BMellor/intelliDesk/README.md

intelliDesk
===========

Intelligent LED lighting controller for a lab workspace. Class project for ECE 5780 University of Utah Spring 2014.
