BMellor/intelliDesk/Design Docs/OLED's/0.96in Blue&White Models/ER-OLED0.96-2_4-Wire-SPI_DemoCode.txt

//----------------------------------------------------------------------
//EASTRISING TECHNOLOGY CO,.LTD.//
// Module    : ER-OLED0.96-2  0.96" (BLUE)
// Lanuage   : C51 Code
// Create    : JAVEN
// Date      : May-16-2013
// Drive IC  : SSD1306
// INTERFACE : 4 Line SPI
// MCU 		 : AT89LV52
// VDD		 : 3.3V   VBAT: 3.6V    
//----------------------------------------------------------------------

#include <AT89X52.H>
#include <intrins.h>

#define uint unsigned int
#define uchar unsigned char
#define RS                     P3_3
#define CS1                    P3_5
#define RST                    P3_4
#define SCLK                  P1_0
#define SDA                   P1_1
sbit	int0=P3^2;
sbit key_add=P0^1;
sbit key_dec=P0^2;
uchar Contrast_level=0xf0;
bit log=0;

#define Start_column	0x00
#define Start_page		0x00
#define	StartLine_set	0x00

void Delay1(uint n);
void Write_number(uchar code *n,uchar k,uchar station_dot);
void display_Contrast_level(uchar number);
void adj_Contrast(void);
void Delay(uint n);
void Write_Data(unsigned char dat);
void Write_Instruction(unsigned char cmd);
void Set_Page_Address(unsigned char add);
void Set_Column_Address(unsigned char add);
void Set_Contrast_Control_Register(unsigned char mod);
void Initial(void);
void Display_Chess(unsigned char value);
void Display_Chinese(unsigned char ft[]);
void Display_Chinese_Column(unsigned char ft[]);
void Display_Picture(unsigned char pic[]);

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
0x00,0x00,0x01,0x01,0x01,0x81,0x41,0xA1,0x51,0xAB,0x57,0xAB,0x55,0xAA,0x75,0xBE,
0x5B,0x2D,0x86,0xF3,0xFF,0xFF,0xFF,0xFF,0xFF,0xFF,0xFF,0xFF,0xFF,0xFF,0xBB,0xCD,
0x56,0x49,0x75,0x9F,0x63,0x09,0xC7,0xF0,0xFF,0xFF,0xFF,0xFF,0xFF,0xFF,0xFF,0xFF,
0xFF,0xFF,0xFF,0xFF,0xFF,0x00,0x00,0x00,0x00,0x10,0x11,0x30,0x30,0x1F,0x08,0x08,
0x08,0x0C,0x06,0x03,0x3F,0x1F,0x02,0x06,0x0C,0x1C,0x08,0x00,0x00,0x00,0x00,0x00,
0x00,0x00,0x00,0x00,0x00,0x00,0x00,0x00,0x00,0x00,0x00,0x7F,0xF0,0x00,0x00,0x00,
0x00,0x00,0x01,0x03,0x06,0x0C,0x0C,0x08,0x10,0x00,0x05,0x03,0x03,0x03,0x00,0x00,
0x00,0x00,0x00,0x00,0x00,0x00,0x00,0x00,0x00,0x00,0x00,0x00,0x00,0x00,0x00,0x00,
0x00,0x00,0x00,0xA0,0x5C,0xAB,0x55,0xAA,0x55,0xAA,0x55,0xAA,0x55,0xEA,0x65,0xB2,
0xF9,0xFE,0xFF,0xFF,0xFF,0xFF,0xFF,0xFF,0xFF,0xFF,0xFF,0xBF,0x5E,0x9F,0x48,0x2A,
0x35,0xBA,0xC5,0xF2,0xFC,0xFF,0xFF,0xFF,0xFF,0xFF,0xFF,0xFF,0xFF,0xFF,0xFF,0xFF,
0xFF,0xFF,0xFF,0xFF,0xFF,0x00,0x00,0x00,0x00,0x20,0x10,0x90,0xD0,0xFC,0xD4,0x90,
0x18,0xC8,0x48,0x48,0xC8,0xC8,0x08,0xF8,0x08,0x18,0x18,0x08,0x00,0x00,0x00,0x00,
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
};

void Step(void) interrupt 0 using 0
{
	Delay1(300);
	if(int0==0)
 // {	while(IE0);
	log=!log;
 // }
   while(!int0);
  return;

}

void Delay1(uint n)
{while(n--);

	return;
}

void Write_number(uchar code *n,uchar k,uchar station_dot)
{uchar i; 
			for(i=0;i<8;i++)
				{
				Write_Data(*(n+16*k+i));
				}
				
	Set_Page_Address(Start_page+1)	;
    Set_Column_Address(Start_column+station_dot*8);	
			for(i=8;i<16;i++)
				{
				Write_Data(*(n+16*k+i));
				}
}

void display_Contrast_level(uchar number)
{	uchar number1,number2,number3;
	number1=number/100;number2=number%100/10;number3=number%100%10;
	Set_Column_Address(Start_column+0*8);
	Set_Page_Address(Start_page);
    Write_number(num,number1,0);
	Set_Column_Address(Start_column+1*8);
	Set_Page_Address(Start_page);
	Write_number(num,number2,1);
	Set_Column_Address(Start_column+2*8);
	Set_Page_Address(Start_page);
	Write_number(num,number3,2);

}

void adj_Contrast(void)
{	Delay1(300);
 	 if((key_add==0)||(key_dec==0))
		{		
		 if	(key_add==0) 
			{Contrast_level+=1;
		   	Set_Contrast_Control_Register(Contrast_level);	
			display_Contrast_level(Contrast_level);
			Delay1(18000);
			if(key_add==0)
				{Delay1(18000);
					if(key_add==0)			
						{Delay1(18000);
							if(key_add==0)
								{Delay1(18000);
									if(key_add==0)

										{while(key_add==0)
											{Contrast_level+=1; 
		   										Set_Contrast_Control_Register(Contrast_level);	
												display_Contrast_level(Contrast_level);
							 					Delay1(20000); 
											}
										}
								}				
						}						
				}												
			}

		 if	(key_dec==0) 
			{Contrast_level-=1; 
		   	Set_Contrast_Control_Register(Contrast_level);	
			display_Contrast_level(Contrast_level);
			Delay1(18000);
			if(key_dec==0)
				{Delay1(18000);
					if(key_dec==0)			
						{Delay1(18000);
							if(key_dec==0)
								{Delay1(18000);
									if(key_dec==0)

										{while(key_dec==0)
											{Contrast_level-=1; 
		   										Set_Contrast_Control_Register(Contrast_level);	
												display_Contrast_level(Contrast_level);
							 					Delay1(20000); 
											}
										}
								}				
						}						
				}												
			}

	  	}
}

void Delay(uint n)
{while(n)
 {    if((key_add==0)||(key_dec==0)) adj_Contrast();
	  n--;
 }
 	for(;log==1;)
	{
 	 if((key_add==0)||(key_dec==0)) adj_Contrast();
	}

	return;
}

void Write_Data(unsigned char dat)
{
  unsigned char  m,da;
  unsigned int j;
     RS=1;
     CS1=0;
     da=dat;
  for(j=0;j<8;j++)
    {
      m=da;
      SCLK=0;
      m=m&0x80;
      if(m==0x80)
        {
           SDA=1;
         }
       else
         {
             SDA=0;
         }
        
        da=da<<1;
        SCLK=1;
      }
  CS1=1;
}

void Write_Instruction(unsigned char cmd)
{
  unsigned char  m,da;
  unsigned int j;
     RS=0;
     CS1=0;
     da=cmd;
  for(j=0;j<8;j++)
    {
      m=da;
      SCLK=0;
      m=m&0x80;
      if(m==0x80)
        {
           SDA=1;
         }
       else
         {
             SDA=0;
         }
        
        da=da<<1;
        SCLK=1;
      }
  CS1=1;
}

// Set page address 0~7
void Set_Page_Address(unsigned char add)
{
    add=0xb0|add;
    Write_Instruction(add);
	return;
}

void Set_Column_Address(unsigned char add)
{
    Write_Instruction((0x10|(add>>4)));
	Write_Instruction((0x0f&add));
	return;
}

void Set_Contrast_Control_Register(unsigned char mod)
{
    Write_Instruction(0x81);
	Write_Instruction(mod);
	return;
}

#pragma disable
void Initial(void)
{
	RST=1;
	Delay(2000);
	RST=0;
	Delay(2000);
	RST=1;

	Delay(2000);

 	Write_Instruction(0xae);//--turn off oled panel

	Write_Instruction(0xd5);//--set display clock divide ratio/oscillator frequency
	Write_Instruction(0x80);//--set divide ratio

	Write_Instruction(0xa8);//--set multiplex ratio(1 to 64)
	Write_Instruction(0x3f);//--1/64 duty

	Write_Instruction(0xd3);//-set display offset
	Write_Instruction(0x00);//-not offset

	Write_Instruction(0x8d);//--set Charge Pump enable/disable
	Write_Instruction(0x14);//--set(0x10) disable

	Write_Instruction(0x40);//--set start line address

	Write_Instruction(0xa6);//--set normal display

	Write_Instruction(0xa4);//Disable Entire Display On

	Write_Instruction(0xa1);//--set segment re-map 128 to 0

	Write_Instruction(0xC8);//--Set COM Output Scan Direction 64 to 0

	Write_Instruction(0xda);//--set com pins hardware configuration
	Write_Instruction(0x12);

	Write_Instruction(0x81);//--set contrast control register
	Write_Instruction(Contrast_level);

	Write_Instruction(0xd9);//--set pre-charge period
	Write_Instruction(0xf1);

	Write_Instruction(0xdb);//--set vcomh
	Write_Instruction(0x40);

	Write_Instruction(0xaf);//--turn on oled panel
}

void Display_Chess(unsigned char value)
{
    unsigned char i,j,k;
    for(i=0;i<0x08;i++)
	{
		Set_Page_Address(i);

        Set_Column_Address(0x00);

		for(j=0;j<0x10;j++)
		{
		    for(k=0;k<0x04;k++)
		        Write_Data(value);
		    for(k=0;k<0x04;k++)
		        Write_Data(~value);
		}
	}
    return;
}

void Display_Chinese(unsigned char ft[])
{
    unsigned char i,j,k,b,c=0;
	unsigned int	num=0;

for(b=0;b<4;b++)
  {
    for(i=0;i<0x02;i++)
	{	Set_Page_Address(c);
    	Set_Column_Address(0x00);
	    num=i*0x10+b*256;
		for(j=0;j<0x08;j++)
		{
            for(k=0;k<0x10;k++)
			{
		        Write_Data(ft[num+k]);
			}
			num+=0x20;
		}c++;
	}
  }
    return;
}

//Display_Chinese1
void Display_Chinese_Column(unsigned char ft[])
{
    unsigned char i,j,k,num=0x40;
    for(i=0;i<0x08;i++)
	{
		Set_Page_Address(i);
        Set_Column_Address(0x00);
		for(j=0;j<0x08;j++)
		{
            for(k=0;k<0x10;k++)
			{
		        Write_Data(ft[num+k]);
			}
		}
	num+=0x10;
	}
    return;
}

void Display_Picture(unsigned char pic[])
{
    unsigned char i,j,num=0;
	for(i=0;i<0x08;i++)
	{
	Set_Page_Address(i);
    Set_Column_Address(0x00);
        for(j=0;j<0x80;j++)
		{
		    Write_Data(pic[i*0x80+j]);
		}
	}
    return;
}

void main(void)
{	IE=0x81;
	IP=0x01;
	TCON=0x01;
	int0=1;
	Delay(100);

    Initial();

	while(1)
	{
        Display_Picture(pic);
		Delay(65000);

		Write_Instruction(0xa7);//--set Inverse Display	
		Delay(65000);

		Write_Instruction(0xa6);//--set normal display
		Display_Picture(pic1);
		Delay(65000);

		Write_Instruction(0xa7);//--set Inverse Display	
		Delay(65000);

		Write_Instruction(0xa6);//--set normal display
		Display_Picture(pic2);
		Delay(65000);

		Write_Instruction(0xa7);//--set Inverse Display	
		Delay(65000);

		Write_Instruction(0xa6);//--set normal display
		Display_Picture(pic3);
		Delay(65000);

		Write_Instruction(0xa7);//--set Inverse Display	
		Delay(65000);

		Write_Instruction(0xa6);//--set normal display
		Display_Picture(pic4);
		Delay(65000);

		Write_Instruction(0xa7);//--set Inverse Display	
		Delay(65000);

		Write_Instruction(0xa6);//--set normal display
		Display_Chess(0x0f);
		Delay(65000);

		Write_Instruction(0xa7);//--set Inverse Display	
		Delay(65000);

		Write_Instruction(0xa6);//--set normal display
		Display_Chinese(font);
		Delay(65000);

		Write_Instruction(0xa7);//--set Inverse Display	
		Display_Chinese(font);
		Delay(65000);

		Write_Instruction(0xa6);//--set normal display
		Display_Chinese_Column(font);
		Delay(65000);

		Write_Instruction(0xa7);//--set Inverse Display	
		Display_Chinese_Column(font);
		Delay(65000);

		Write_Instruction(0xa6);//--set normal display
	}
}
