BMellor/intelliDesk/Design Docs/Website/index.htm

intelliDesk ECE 5780 Project

INTRO BLOG HARDWARE SOFTWARE RESULTS MEDIA APPENDIX REFERENCE

CreativeCommons (https://creativecommons.org/licenses/by-sa/4.0/legalcode) 2014 - Brent Mellor
