BMellor/intelliDesk/Design Docs/Website/data/media/displayBox.jpg

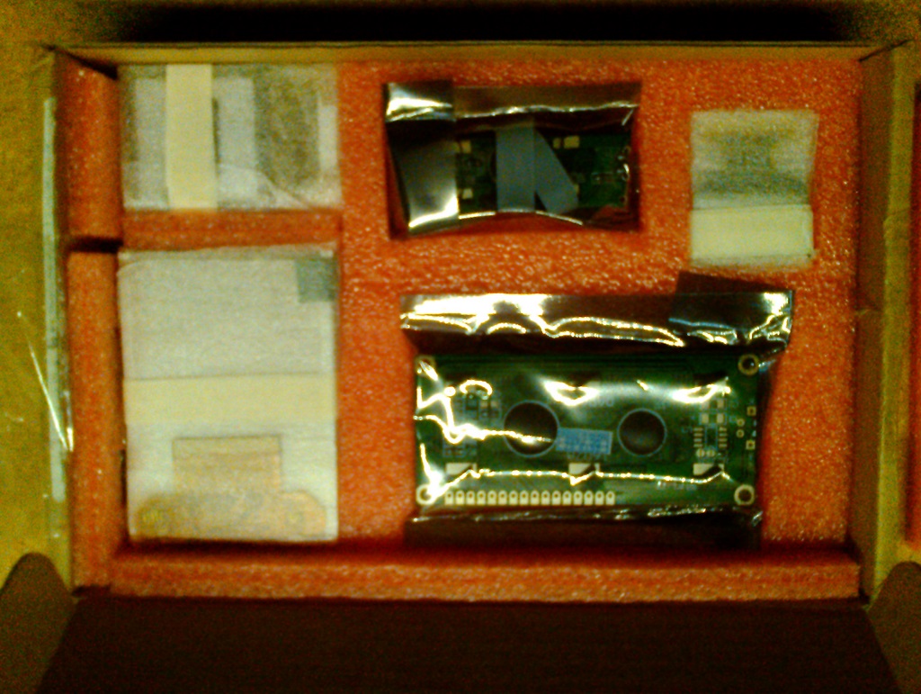
Design Docs/Website/data/media/displayBox.jpg
