BMellor/intelliDesk/Design Docs/Website/data/media/oleds.JPG

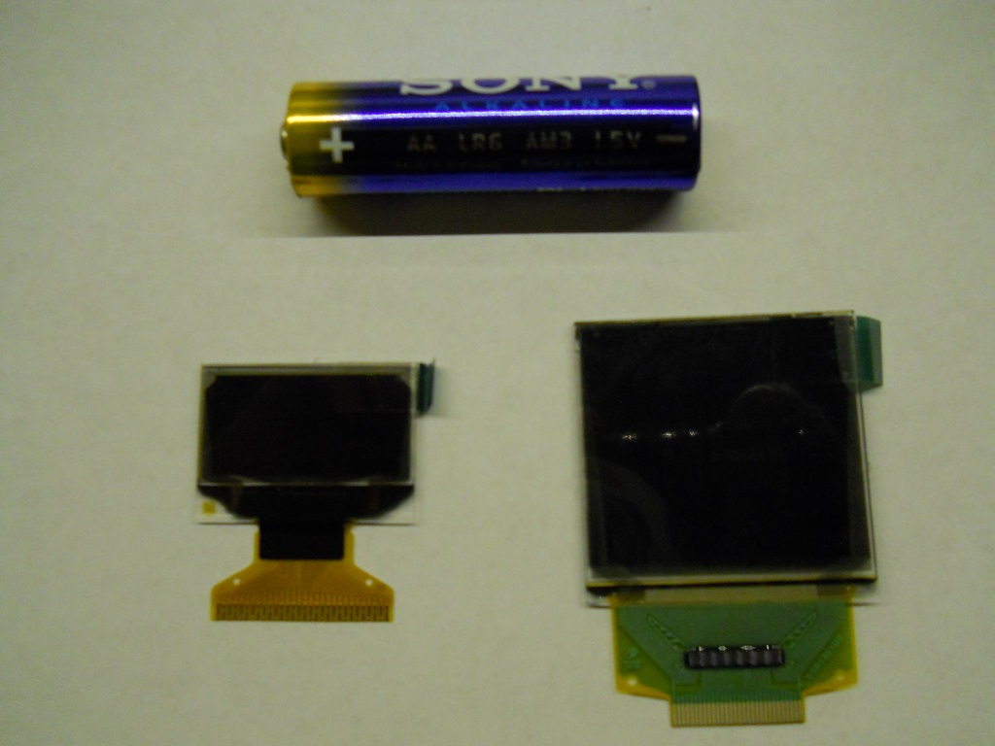
Design Docs/Website/data/media/oleds.JPG
