BMellor/intelliDesk/Design Docs/Website/data/media/pyralux.JPG

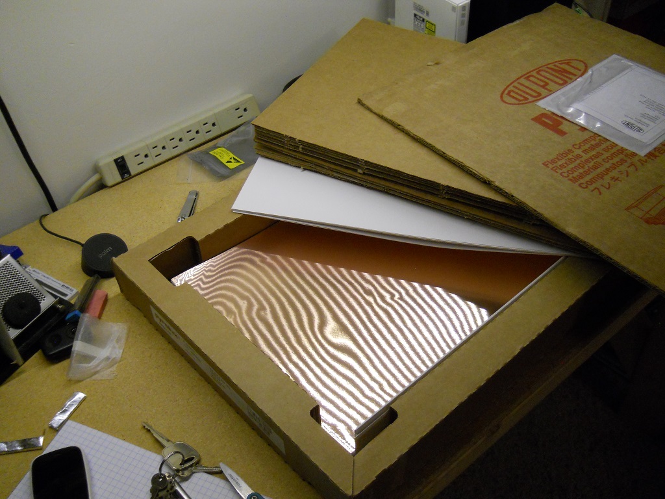
Design Docs/Website/data/media/pyralux.JPG
