BMellor/intelliDesk/Design Docs/Website/data/media/pyraluxBox.JPG

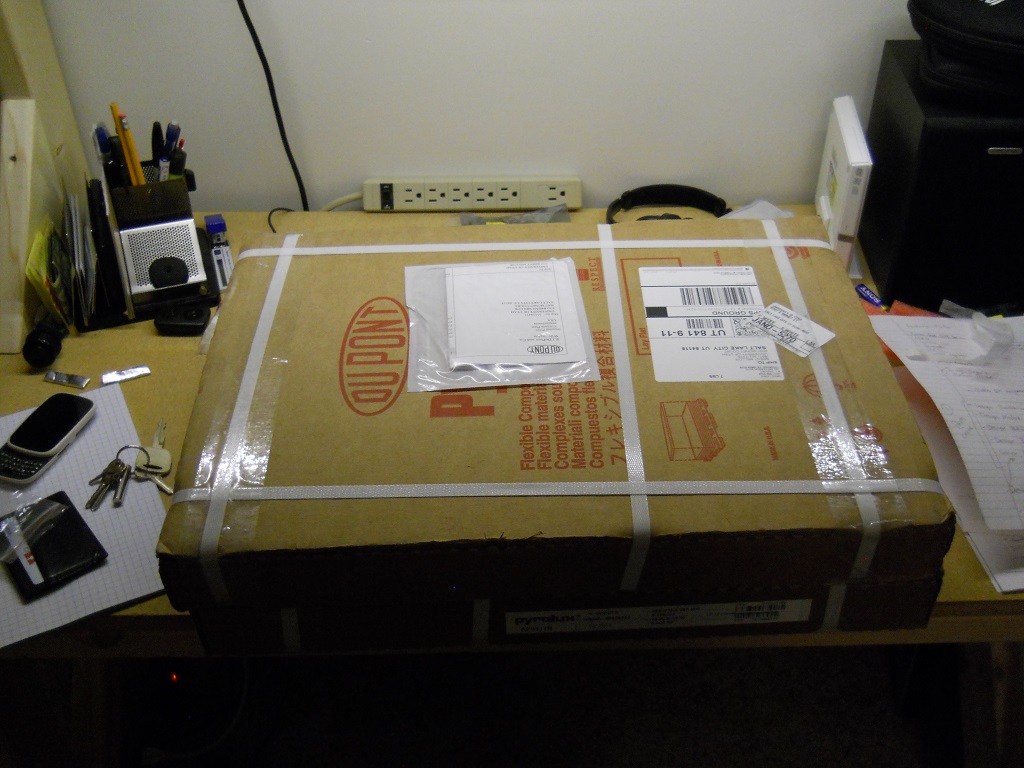
Design Docs/Website/data/media/pyraluxBox.JPG
