BMellor/intelliDesk/(list of files, cad)

Other CAD files:
Design Docs/OLED's/0.96in Blue&White Models/Screen.dwg
Design Docs/Proposal/capsense.dwg
Design Docs/screens.dwg
