BMellor/intelliDesk/EAGLE Files/Sensor Breakout/sensor_breakout.brd

## EAGLE design EAGLE Files/Sensor Breakout/sensor_breakout.brd (2014-03-26)

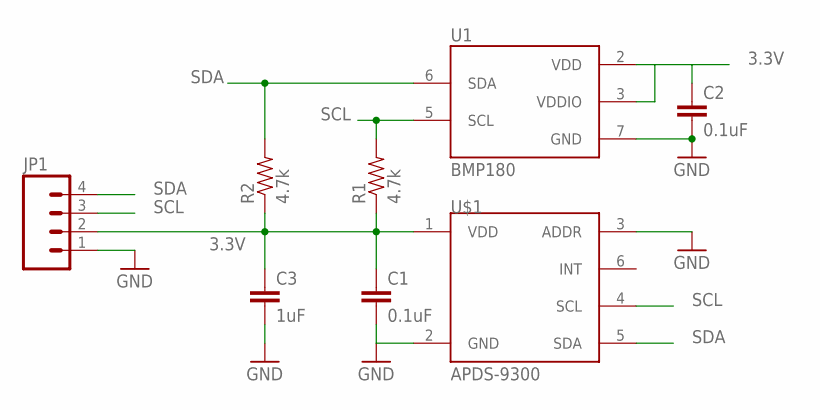
[picture p8: schematic sensor_breakout.sch]

Parts:
C1, C2: 0.1uF; 0402-S
C3: 1uF; 0402-S
JP1: M04LOCK; 1X04_LOCK
R1, R2: 4.7k; 0402-S
U1: BMP180
U$1: APDS-9300; CHIPLED

Connections:
3.3V: C1.1, C2.1, C3.1, JP1.2, R1.1, R2.1, U1.2 (VDD), U1.3 (VDDIO), U$1.1 (VDD)
GND: C1.2, C2.2, C3.2, JP1.1, U1.7 (GND), U$1.2 (GND), U$1.3 (ADDR)
SCL: JP1.3, R1.2, U1.5 (SCL), U$1.4 (SCL)
SDA: JP1.4, R2.2, U1.6 (SDA), U$1.5 (SDA)

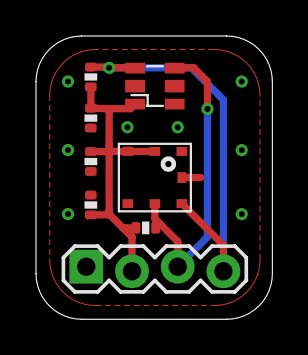
[picture p9: board sensor_breakout.brd from above]

Board: 2 copper layers, 13.1 x 15.7 mm, 8 parts (0 on the bottom side), 4 nets.
