BMellor/intelliDesk/EAGLE Files/Combined Breakout/combined_breakout.brd

## EAGLE design EAGLE Files/Combined Breakout/combined_breakout.brd (2014-03-25)

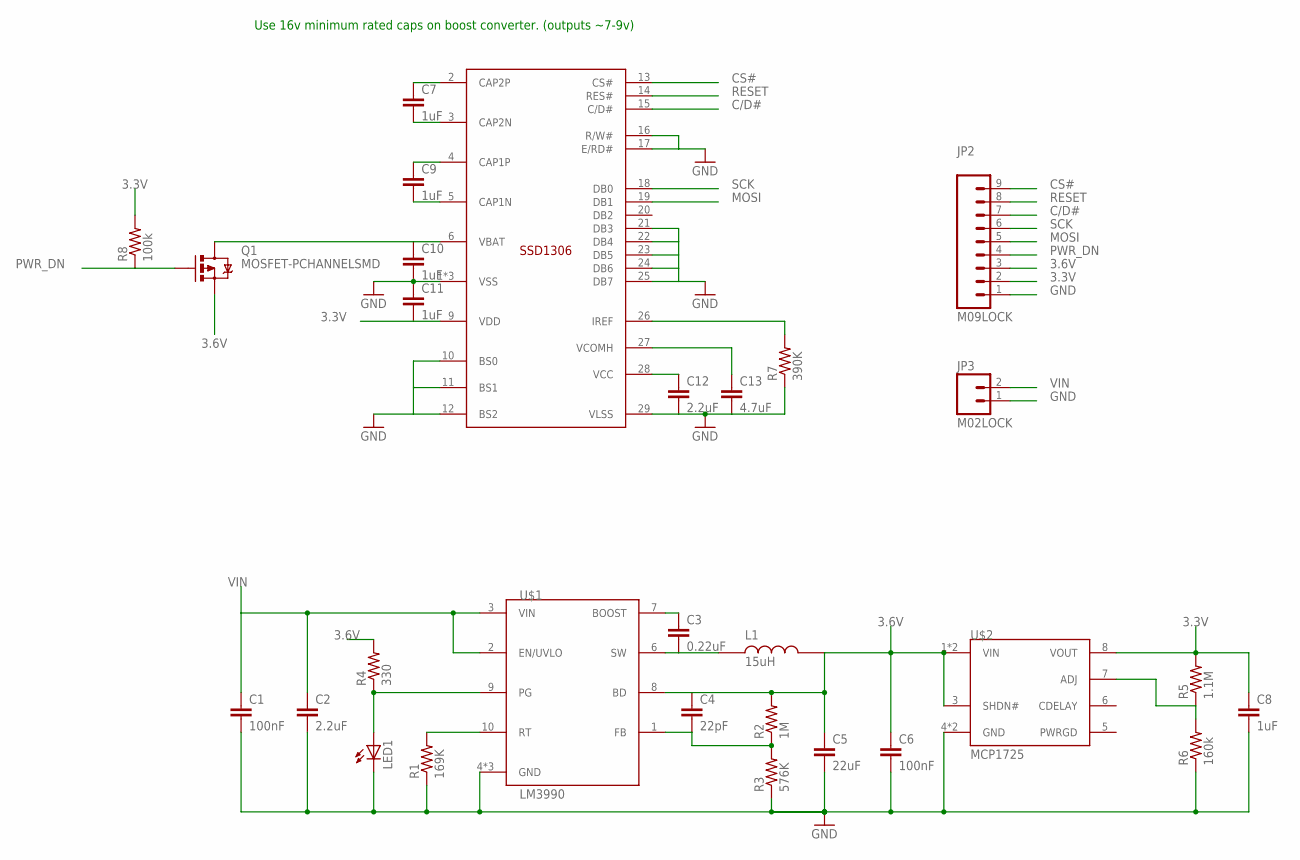
[picture p10: schematic combined_breakout.sch]

Parts:
C1, C6: 100nF; 0603-CAP
C2: 2.2uF; 1206
C3: 0.22uF; 0603-CAP
C4: 22pF; 0603-CAP
C5: 22uF; 1206
C7, C9, C10, C11: 1uF; 0402-S
C8: 1uF; 0603-CAP
C12: 2.2uF; 0402-S
C13: 4.7uF; 0402-S
JP2: M09LOCK; 1X09_LOCK
JP3: M02LOCK; 1X02_LOCK
L1: 15uH; NR6028T150M
LED1: LED0603; LED-0603
Q1: MOSFET-PCHANNELSMD; SOT23-3
R1: 169K; 0402-S
R2: 1M; 0402-S
R3: 576K; 0402-S
R4: 330; 0402-S
R5: 1.1M; 0402-S
R6: 160k; 0402-S
R7: 390K; 0402-S
R8: 100k; 0402-S
U$1: LM3990; DD10
U$2: MCP1725; 2X3_DFN
U$3: ER-OLED0.96-2

Connections:
3.3V: C8.1, C11.2, JP2.2, R5.2, R8.2, U$2.8 (VOUT), U$3.9 (VDD)
3.6V: C4.1, C5.1, C6.1, JP2.3, L1.2, Q1.2 (S), R2.2, R4.2, U$1.8 (BD), U$2.1 (VIN), U$2.2 (VIN), U$2.3 (SHDN#)
C/D#: JP2.7, U$3.15 (C/D#)
CS#: JP2.9, U$3.13 (CS#)
FB: C4.2, R2.1, R3.2, U$1.1 (FB)
GND: C1.2, C2.2, C5.2, C6.2, C8.2, C10.2, C11.1, C12.2, C13.2, JP2.1, JP3.1, LED1.C, R1.1, R3.1, R6.1, R7.1, U$1.4 (GND), U$1.5 (GND), U$1.EP\ (GND), U$2.4 (GND), U$2.EP (GND), U$3.1 (VSS), U$3.8 (VSS), U$3.10 (BS0), U$3.11 (BS1), U$3.12 (BS2), U$3.16 (R/W#), U$3.17 (E/RD#), U$3.21 (DB3), U$3.22 (DB4), U$3.23 (DB5), U$3.24 (DB6), U$3.25 (DB7), U$3.29 (VLSS), U$3.30 (VSS)
MOSI: JP2.5, U$3.19 (DB1)
unnamed: C12.1, U$3.28 (VCC)
unnamed: LED1.A, R4.1, U$1.9 (PG)
unnamed: C13.1, U$3.27 (VCOMH)
unnamed: C3.1, U$1.7 (BOOST)
unnamed: R7.2, U$3.26 (IREF)
unnamed: R5.1, R6.2, U$2.7 (ADJ)
unnamed: R1.2, U$1.10 (RT)
unnamed: C9.1, U$3.4 (CAP1P)
unnamed: C9.2, U$3.5 (CAP1N)
unnamed: C7.2, U$3.3 (CAP2N)
unnamed: C7.1, U$3.2 (CAP2P)
unnamed: C10.1, Q1.3 (D), U$3.6 (VBAT)
PWR_DN: JP2.4, Q1.1 (G), R8.1
RESET: JP2.8, U$3.14 (RES#)
SCK: JP2.6, U$3.18 (DB0)
SW: C3.2, L1.1, U$1.6 (SW)
VIN: C1.1, C2.1, JP3.2, U$1.2 (EN/UVLO), U$1.3 (VIN)

Notes on the sheet:
Use 16v minimum rated caps on boost converter. (outputs ~7-9v)

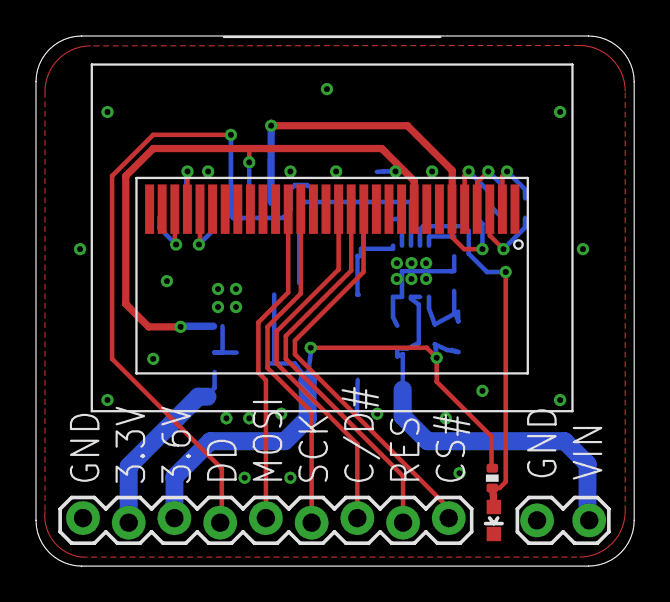
[picture p11: board combined_breakout.brd from above]

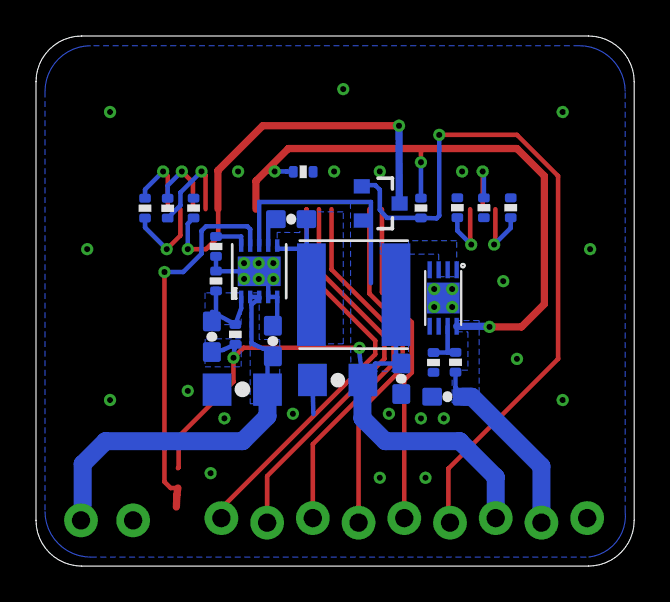
[picture p12: board combined_breakout.brd from below]

Board: 2 copper layers, 33.2 x 29.4 mm, 29 parts (24 on the bottom side), 24 nets.
