BMellor/intelliDesk/EAGLE Files/OLED Breakout/oledBreakout.brd

## EAGLE design EAGLE Files/OLED Breakout/oledBreakout.brd (2014-03-19)

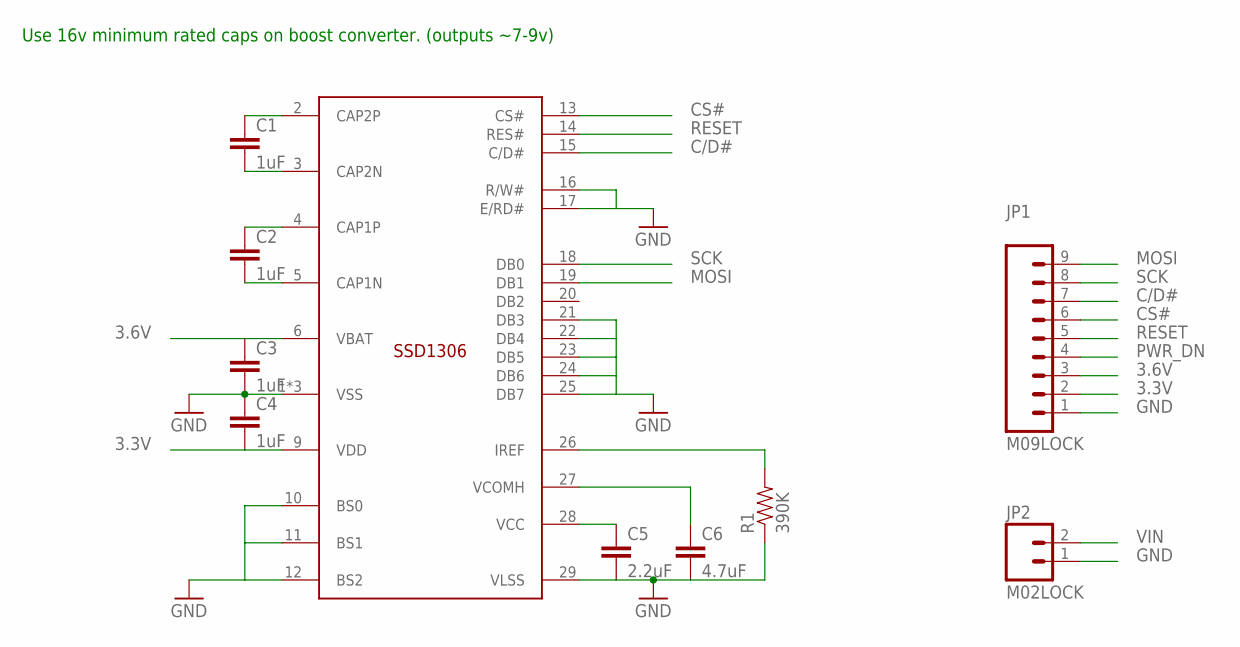
[picture p13: schematic oledBreakout.sch]

Parts:
C1, C2, C3, C4: 1uF; 0402-CAP
C5: 2.2uF; 0402-CAP
C6: 4.7uF; 0402-CAP
JP1: M09LOCK; 1X09_LOCK
JP2: M02LOCK; 1X02_LOCK
R1: 390K; 0402-RES
U$1: ER-OLED0.96-2

Connections:
3.3V: C4.2, JP1.2, U$1.9 (VDD)
3.6V: C3.1, JP1.3, U$1.6 (VBAT)
C/D#: JP1.7, U$1.15 (C/D#)
CS#: JP1.6, U$1.13 (CS#)
GND: C3.2, C4.1, C5.2, C6.2, JP1.1, JP2.1, R1.1, U$1.1 (VSS), U$1.8 (VSS), U$1.10 (BS0), U$1.11 (BS1), U$1.12 (BS2), U$1.16 (R/W#), U$1.17 (E/RD#), U$1.21 (DB3), U$1.22 (DB4), U$1.23 (DB5), U$1.24 (DB6), U$1.25 (DB7), U$1.29 (VLSS), U$1.30 (VSS)
MOSI: JP1.9, U$1.19 (DB1)
unnamed: C5.1, U$1.28 (VCC)
unnamed: C6.1, U$1.27 (VCOMH)
unnamed: R1.2, U$1.26 (IREF)
unnamed: C2.2, U$1.5 (CAP1N)
unnamed: C2.1, U$1.4 (CAP1P)
unnamed: C1.2, U$1.3 (CAP2N)
unnamed: C1.1, U$1.2 (CAP2P)
PWR_DN: JP1.4
RESET: JP1.5, U$1.14 (RES#)
SCK: JP1.8, U$1.18 (DB0)
VIN: JP2.2

Notes on the sheet:
Use 16v minimum rated caps on boost converter. (outputs ~7-9v)

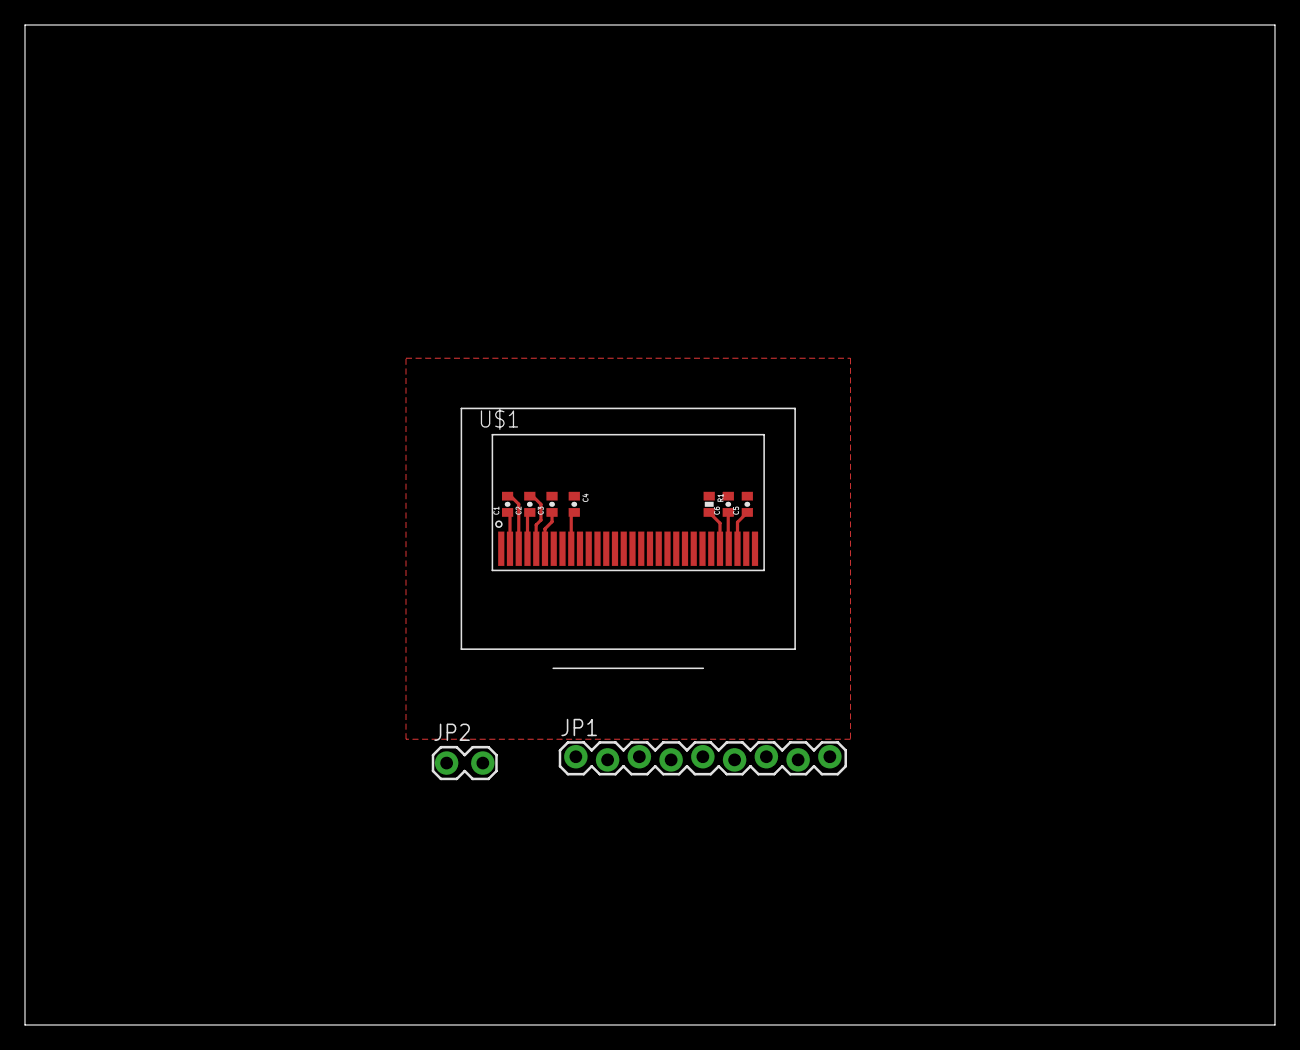
[picture p14: board oledBreakout.brd from above]

Board: 2 copper layers, 100.0 x 80.0 mm, 10 parts (0 on the bottom side), 15 nets.
