BMellor/intelliDesk/(commit log)

2014-03-13 Moved existing design files into Git repo. Added initial design of buck-mode power supply breakout.
    [Screen.dwg, buck_breakout.brd, buck_breakout.sch, capsense.dwg, screens.dwg]
2014-03-13 Added polygons to power supply breakout. Text still needs fixing.
2014-03-13 Added polygons to power board. Text needs fixing.
    [buck_breakout.brd]
2014-03-14 Added linear reg to power board. Layout ver 1.
    [Screen.dwg, buck_breakout.brd, buck_breakout.sch]
2014-03-14 Rerouted for nicer layout on linear supply
    [buck_breakout.brd, buck_breakout.sch]
2014-03-15 fixed via size and removed most silkscreen on power breakout pcb
    [buck_breakout.brd, buck_breakout.sch]
2014-03-15 Removed unneeded capacitor on linear supply. Turns out that cap was needed only for power good indicator.
    [buck_breakout.brd]
2014-03-15 Added OLED breakout board. (not yet designed) Added linear regulator datasheet. Updated parts library.
    [buck_breakout.brd, buck_breakout.sch, oledBreakout.brd, oledBreakout.sch]
2014-03-18 OLED breakout mostly finished. Need to merge with power breakout and decide on header/outputs.
    [oledBreakout.brd, oledBreakout.sch]
2014-03-19 Combined power/OLED breakouts. Not yet routed completely.
    [combined_breakout.brd, combined_breakout.sch, oledBreakout.brd, oledBreakout.sch]
2014-03-20 Routing combined breakout board.
    [combined_breakout.brd, combined_breakout.sch]
2014-03-21 Finally finished combined breakout board. It's pretty ugly but it will work for prototyping purposes.
    [buck_breakout.brd, combined_breakout.brd, combined_breakout.sch]
2014-03-25 Adjusted spacing on some of the components on the combined breakout board. Removed some silkscreen that was in the way. Checked with freeDFM, sent gerbers off to circuitgraphics!
    [combined_breakout.brd, combined_breakout.sch]
2014-03-26 Added sensor breakout board. Sent off to CircuitGraphics...
    [sensor_breakout.brd, sensor_breakout.sch]
2014-03-26 Forgot to adjust physical outline of the board. Fixed and board is now really uploaded to CircuitGraphics.
    [sensor_breakout.brd]
